mkkf1532/ESPHome-Hi-Fi-Streamer/(list of files, cad)

Other CAD files:
Streamer_case.f3d
